joe-skb7/car-rf/doc/motor-driver/module-view.jpg

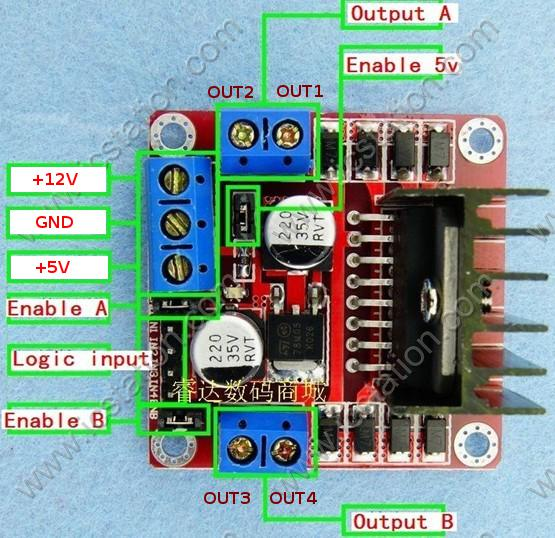
doc/motor-driver/module-view.jpg
