joe-skb7/car-rf/doc/motor-driver/module-scheme.jpg

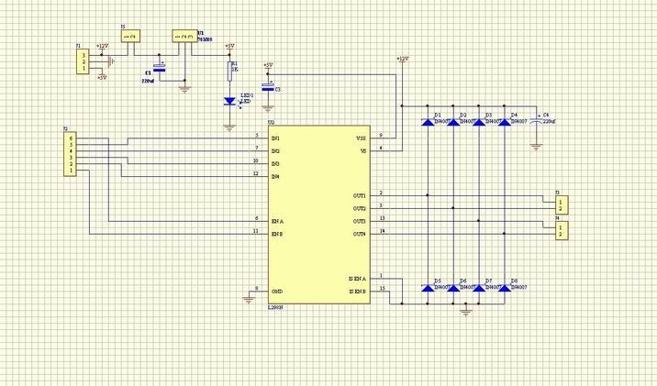
doc/motor-driver/module-scheme.jpg
