joe-skb7/car-rf/doc/ideas.txt

- use protothreads:
  - http://dunkels.com/adam/pt/
  - http://en.wikipedia.org/wiki/Protothreads
- mechanical hand
- 3d-scanner (build map) using laser, camera and beaglebone:
  http://www.makerscanner.com/
  (see MakerBot Digitizer, two-laser scan)
- motor encoders (for monitoring or auto-controlling the speed)
- compass (figure out which rotation angle was accomplished)
- accelerometer/GPS (figure out the speed of car)
