joe-skb7/car-rf/doc/servo/links.txt

http://easyelectronics.ru/servomashinka-hs-311.html
