joe-skb7/car-rf/doc/car/car-scheme.png

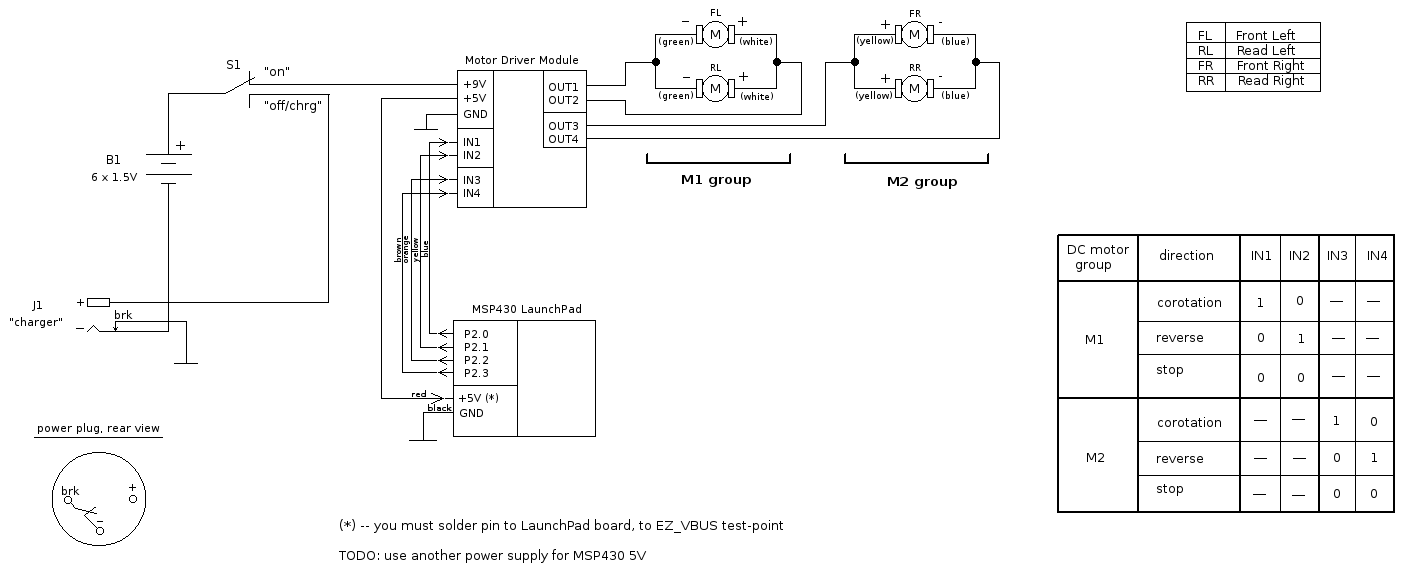
doc/car/car-scheme.png
