joe-skb7/car-rf/doc/joystick/scheme/joystick-connection-scheme.png

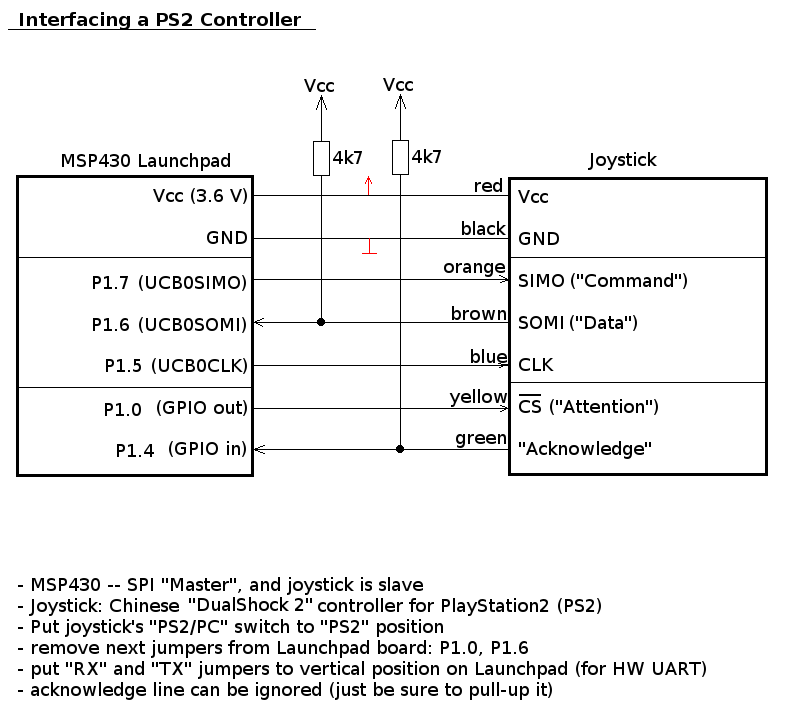
doc/joystick/scheme/joystick-connection-scheme.png
