joe-skb7/car-rf/doc/joystick/spi-config/spi-grace.png

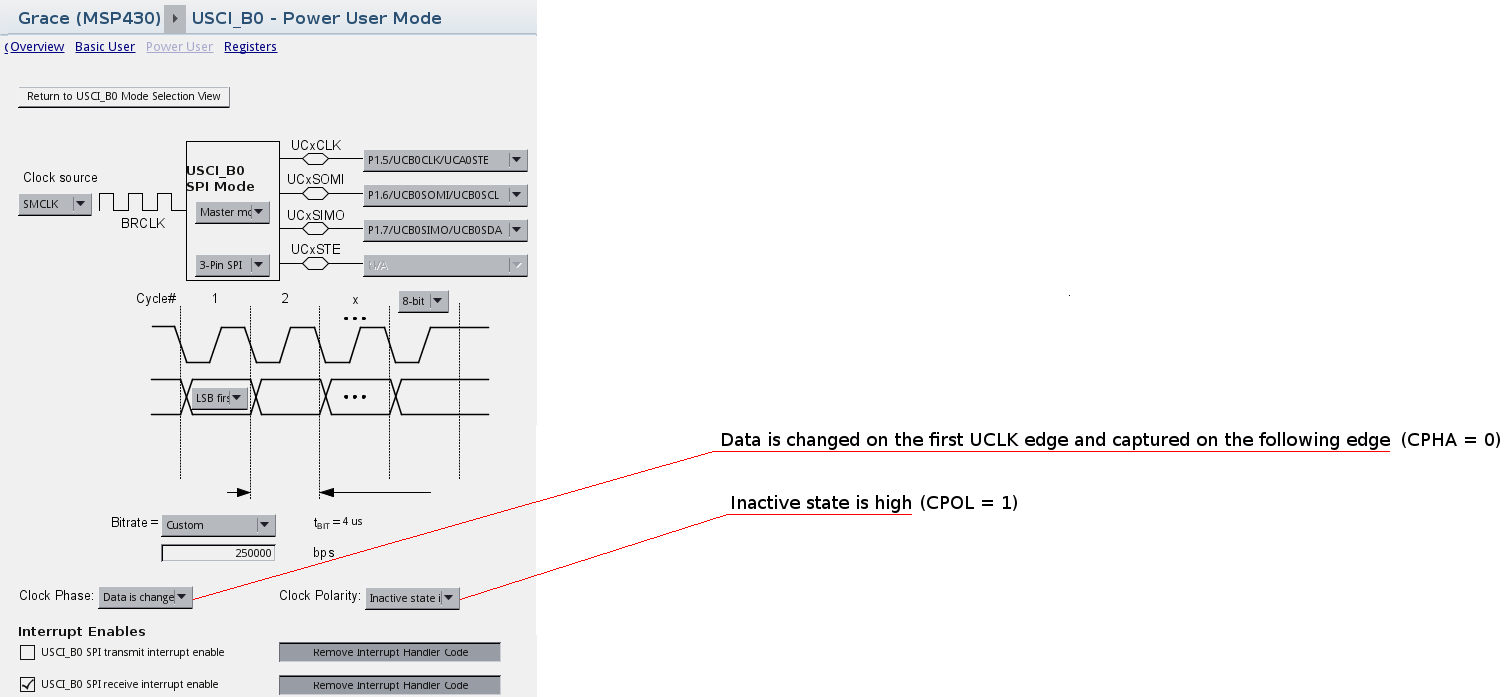
doc/joystick/spi-config/spi-grace.png
