joe-skb7/car-rf/doc/motor/motor-photo.jpg

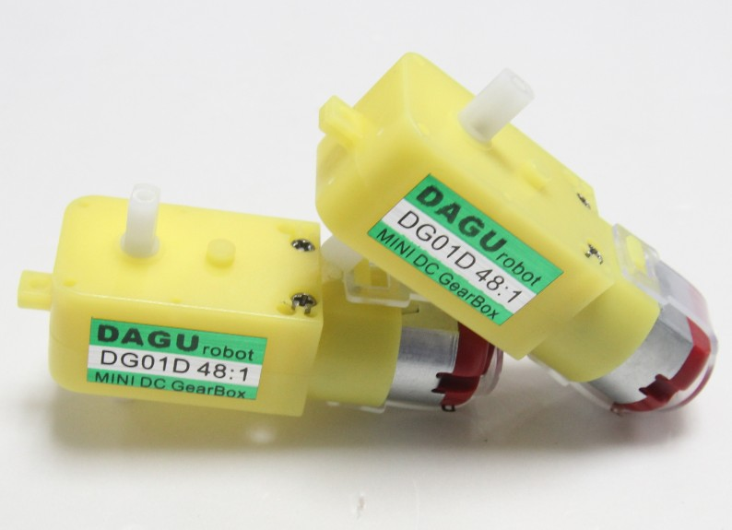
doc/motor/motor-photo.jpg
