joe-skb7/car-rf/doc/uart/uart-pc-scheme.png

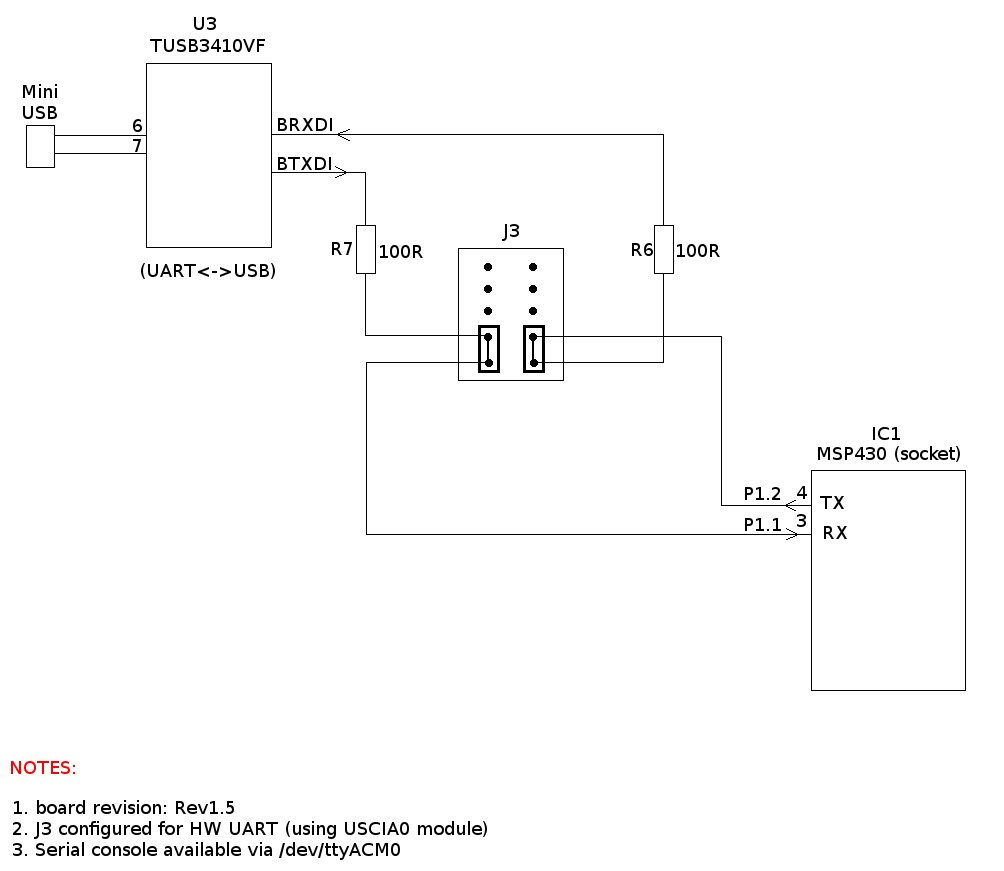
doc/uart/uart-pc-scheme.png
