joe-skb7/car-rf/doc/wireless/spi-config/wl-spi-grace.png

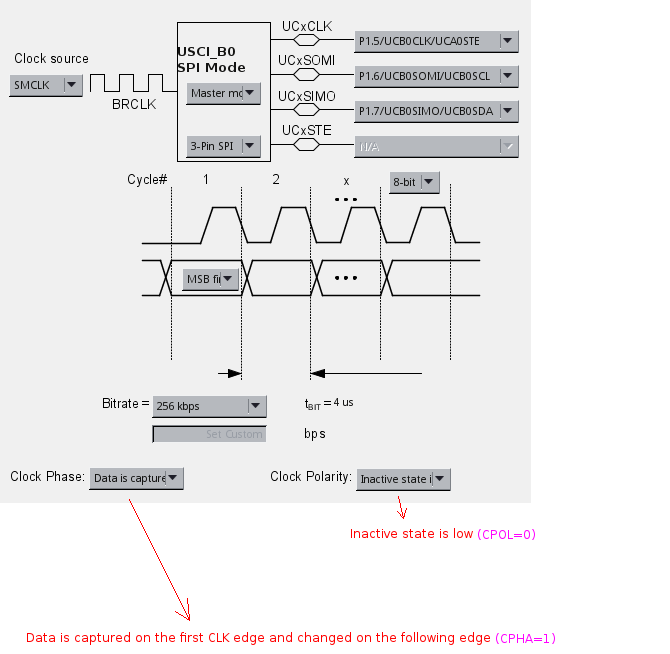
doc/wireless/spi-config/wl-spi-grace.png
