joe-skb7/car-rf/doc/wireless/tk0348-module/NRF24L012_BottomView.jpg

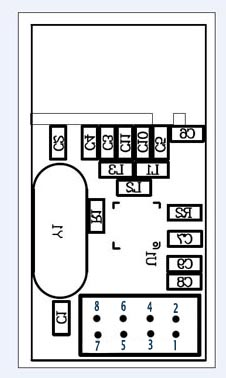
doc/wireless/tk0348-module/NRF24L012_BottomView.jpg
