joe-skb7/car-rf/doc/car/car-wiring.png

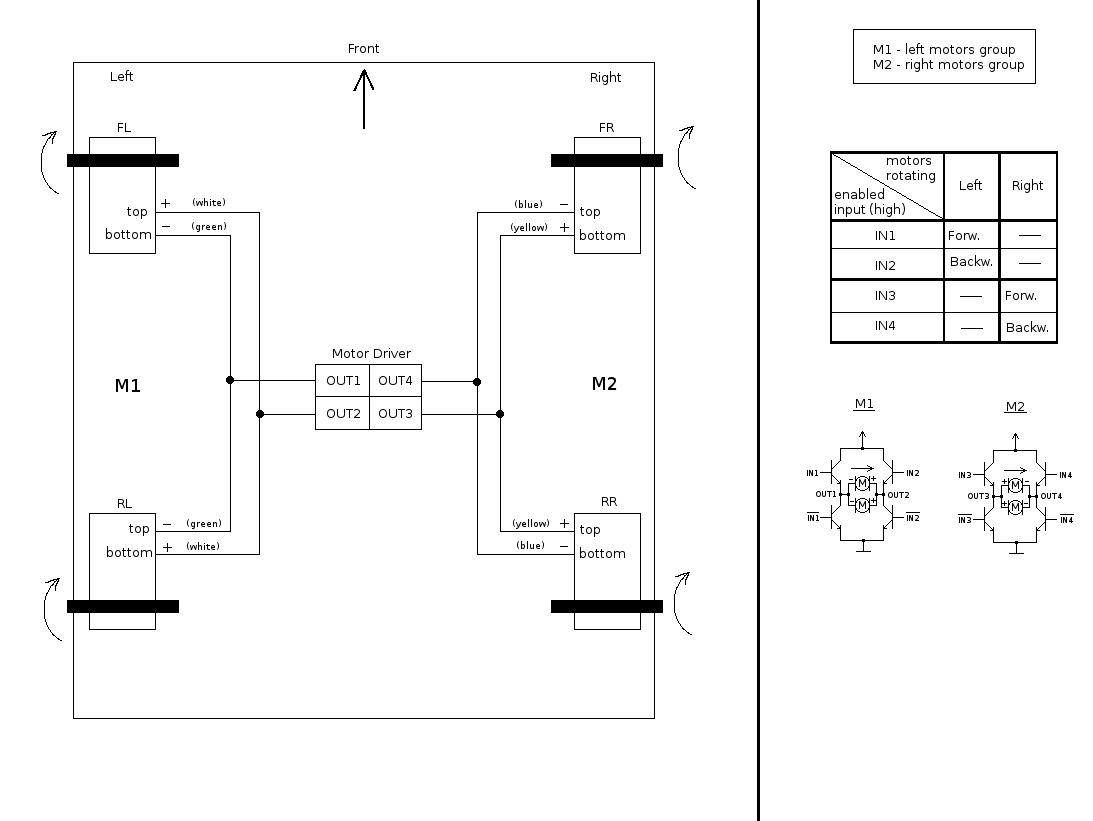
doc/car/car-wiring.png
