joe-skb7/car-rf/doc/pin-usage-scheme.png

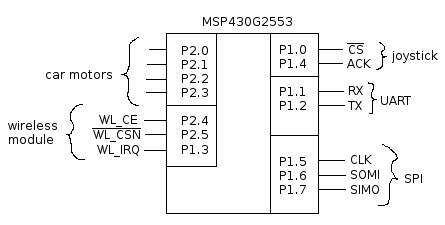
doc/pin-usage-scheme.png
