joe-skb7/car-rf/doc/motor-driver/fix01.txt

Ceramic capacitors 100nF were added to Vs and Vss lines, as recommended by L298 datasheet.
They were soldered to motor driver module board near GND pin.
