joe-skb7/car-rf/doc/motor-suppressor/suppressor-files/pdf/ComponentSilkscreen.pdf

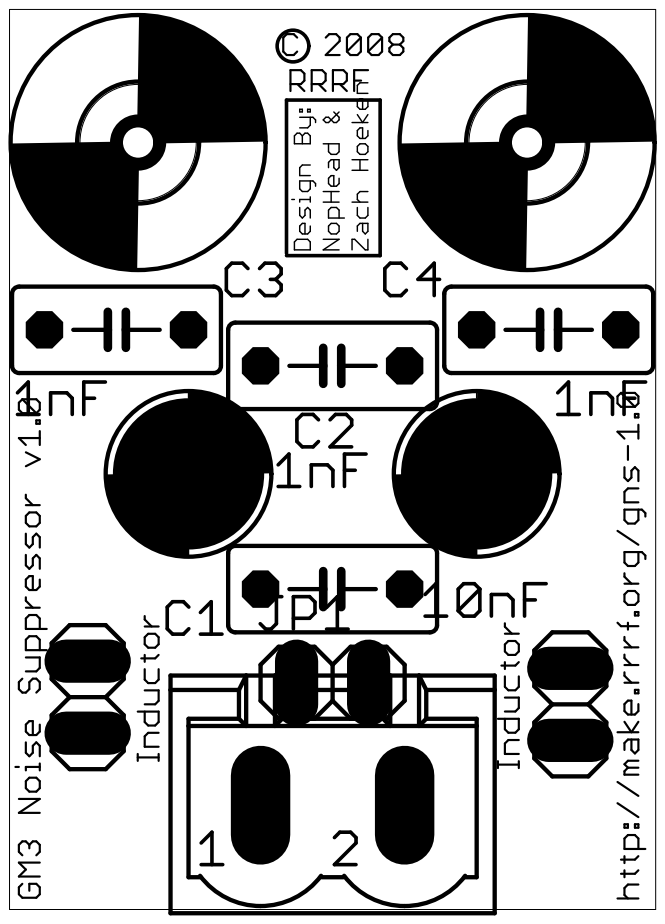
[picture p12: page 1]
