joe-skb7/car-rf/doc/motor-suppressor/suppressor-files/pdf/Schematic.pdf

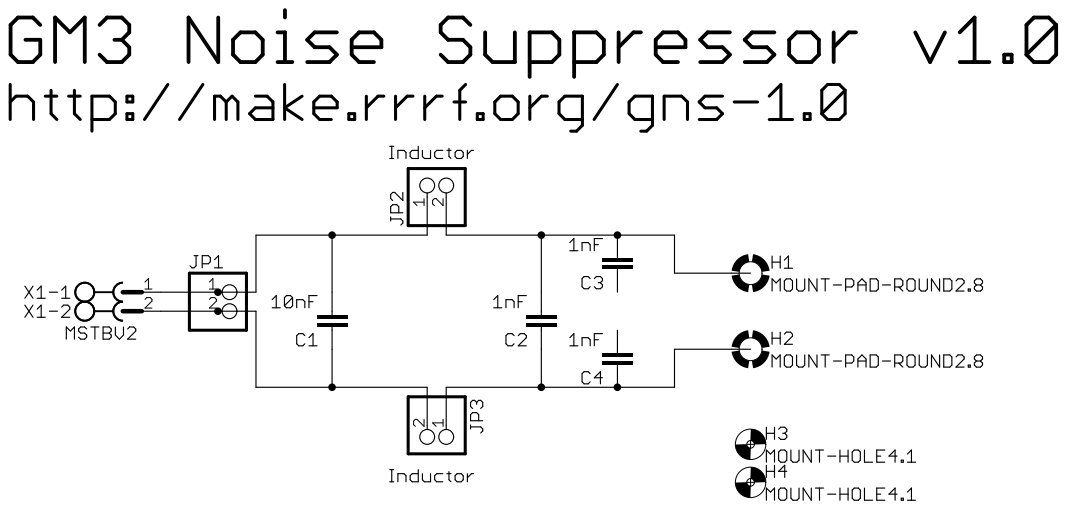
[picture p13: page 1]
