joe-skb7/car-rf/doc/js-wl-boosterpack/eagle/js-wl-msp430.brd

## EAGLE design doc/js-wl-boosterpack/eagle/js-wl-msp430.brd (2013-10-19)

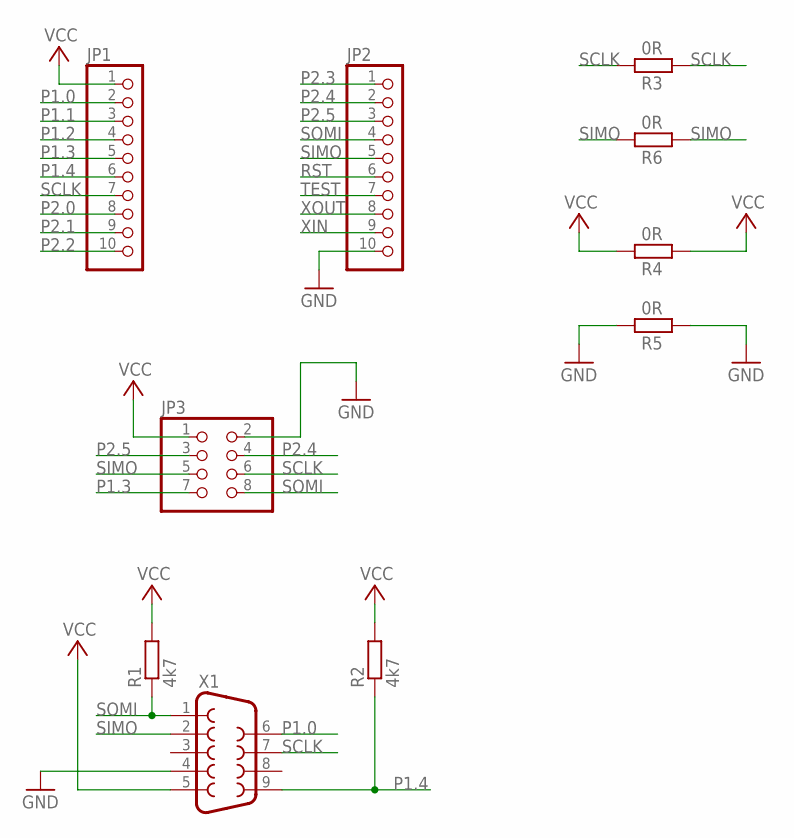
[picture p14: schematic js-wl-msp430.sch]

Parts:
JP1, JP2: PINHD-1X10; 1X10
JP3: PINHD-2X4; 2X04
R1, R2: 4k7; R1206
R3: 0R; R1206
R4, R5, R6: 0R; 0207/12
X1: DB9MALE; DB9_MALE

Connections:
GND: JP2.10, JP3.2, R5.1, R5.2, X1.4
P1.0: JP1.2, X1.6
P1.1: JP1.3
P1.2: JP1.4
P1.3: JP1.5, JP3.7
P1.4: JP1.6, R2.1, X1.9
P2.0: JP1.8
P2.1: JP1.9
P2.2: JP1.10
P2.3: JP2.1
P2.4: JP2.2, JP3.4
P2.5: JP2.3, JP3.3
RST: JP2.6
SCLK: JP1.7, JP3.6, R3.1, R3.2, X1.7
SIMO: JP2.5, JP3.5, R6.1, R6.2, X1.2
SOMI: JP2.4, JP3.8, R1.1, X1.1
TEST: JP2.7
VCC: JP1.1, JP3.1, R1.2, R2.2, R4.1, R4.2, X1.5
XIN: JP2.9
XOUT: JP2.8

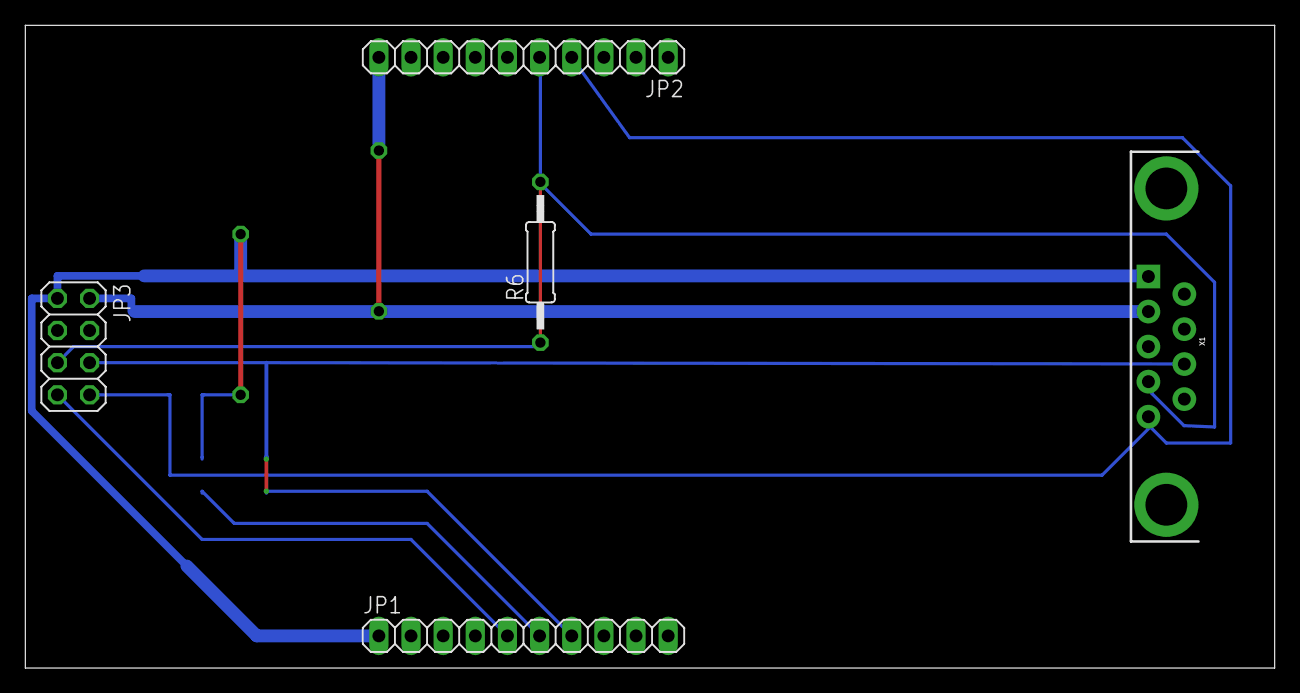
[picture p15: board js-wl-msp430.brd from above]

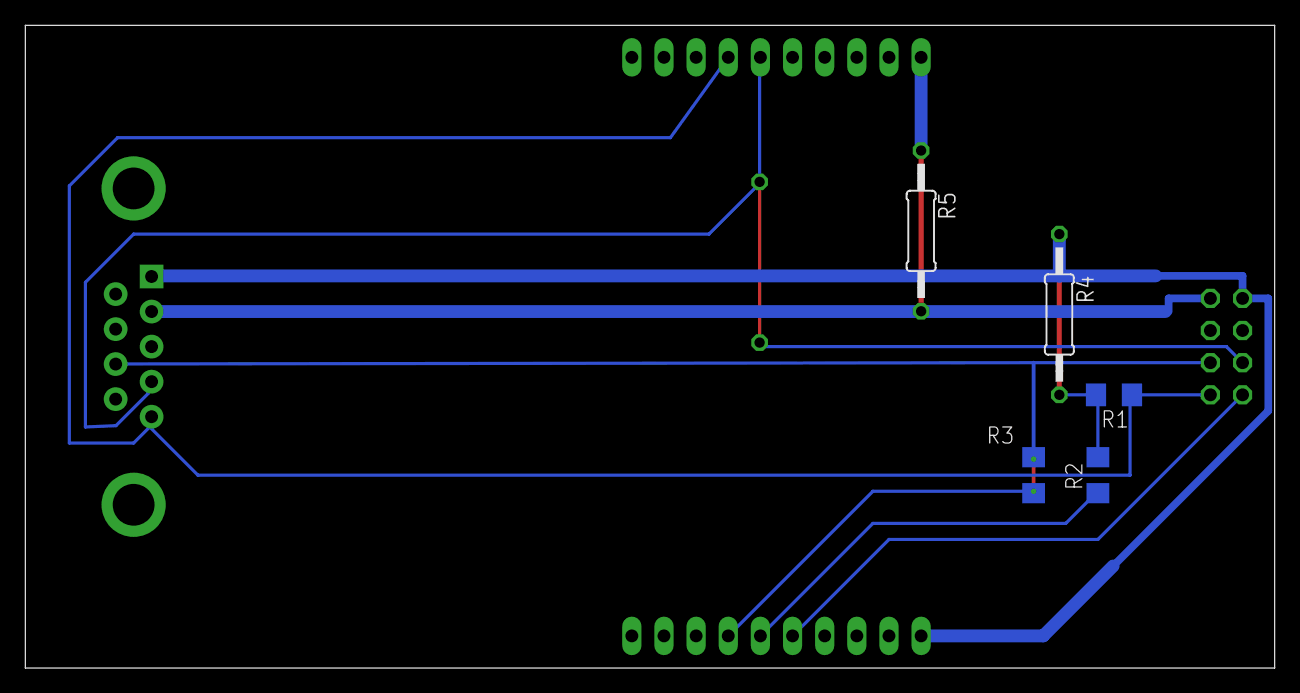
[picture p16: board js-wl-msp430.brd from below]

Board: 2 copper layers, 98.7 x 50.8 mm, 10 parts (5 on the bottom side), 10 nets.
