joe-skb7/car-rf/joystick-wifi/src/ds2/ds2.c

#include <spi/spi.h>
#include <ds2/ds2.h>
#include <msp430.h>

void ds2_init_spi(void)
{
	spi_init(0, 1, 0);
}

void ds2_init(void)
{
	/* P1.0 - OUT (Joystick's Chip Select, "Attention")
	 * P1.4 - IN  ("Acknowledge")
	 */
	P1DIR |= BIT0;
	P1OUT |= BIT0; /* up on idle */

	ds2_init_spi();
}

void ds2_poll_buttons_sync(unsigned int *buttons)
{
	unsigned char request[] = {0x01, 0x42, 0x00, 0x00, 0x00, 0x00, 0x00,
		0x00, 0x00};
	unsigned char response[9];

	ds2_send_receive_packet_sync(request, response, 9);

	if (buttons) {
		((uint8_t*)buttons)[0] = response[3];
		((uint8_t*)buttons)[1] = response[4];
	}
}

void ds2_send_receive_packet_sync(const unsigned char* send_packet,
		unsigned char* receive_packet, size_t size)
{
	/* Enable Joystick Chip Select: set "Attention" line to 0 */
	P1OUT &= ~BIT0;

	spi_send_receive_packet_sync(send_packet, receive_packet, size);

	/* Release CS */
	P1OUT |= BIT0;
}

/* TODO: do smth w/ handshake routine */
#if 0
int ds2_handshake(void)
{
	uint8_t send_data[] = {0x01, 0x01, 0x01, 0x01, 0x01, 0x01};
	uint8_t receive_data[6];
	size_t i;

	spi_send_receive_packet_sync(send_data, receive_data, 6);

	for (i = 0; i < 6; ++i) {
		if (0xff != receive_data[i])
			return 1;
	}

	return 0;
}
#endif
