joe-skb7/car-rf/(commit log)

2013-08-31 initial commit
    By now we have joystick and UART (PC serial console) working.
    [BOM.ods, joe-breakout.brd, joystick-protocol-at-startup.ods, spi-params.txt]
2013-08-31 Moved ds2 and spi code to their corresponding .h and .c files
2013-08-31 Moved some functions from ds2 to spi
2013-08-31 Moved interrupt stuff to interrupts.c
2013-08-31 cc2500: improve cc2500 breakout PCB
    Arrange two same PCBs horizontally (instead of vertical layout)
    so that it can be printed with economy of PCB tape.
    [joe-breakout.brd]
2013-08-31 ds2: fix sparse warning
    Thi patch fixes next sparse warning:
    "./src/ds2/ds2.c:3:6: warning: symbol 'ds2_poll_buttons_sync' was not declared.
    Should it be static?"
    [ds2.c]
2013-08-31 makefile: check static analyzer parameters
    With "-quiet" parameter splint gave such a warning:
    "Command Line: Setting -quiet redundant with current value"
    So remove "-quiet" for now.
2013-08-31 interrupts: fix static analyzer warnings
    Fix next warnings gotten from splint:
    src/interrupts.c: (in function usci0rx_isr)
    src/interrupts.c:35:17: Function usci0a_rx_cb expects arg 1 to be uint8_t gets
    char: (char)UCA0RXBUF
    src/interrupts.c:41:17: Function usci0b_rx_cb expects arg 1 to be uint8_t gets
    char: (char)UCB0RXBUF
2013-08-31 joystick: remove duplicate uart scheme
2013-08-31 joystick: move joystick files 1 level top
    After removing duplicate scheme, there is 1 redundant dir level.
    Fix it.
    [ds2.c, main.c, spi.c]
2013-08-31 doc: move doc files to dedicated directory
    [BOM.ods]
2013-09-01 rearrange project stucture
    Project structure was a way redundant. Fix it.
    [joe-breakout.brd, joystick-protocol-at-startup.ods, spi-params.txt]
2013-09-01 doc: sync BOM to be up-to-date
    [BOM.ods]
2013-09-01 doc: convert BOM to CSV
    CSV is text format and should be better for git that ODS.
    [BOM.ods, bom.csv]
2013-09-01 interrupts: unify coding style
2013-09-01 spi: coding issues
2013-09-01 uart: fix comment
2013-09-01 spi: mark debug code for remove
2013-09-01 spi: coding style: general headers on top
2013-09-01 spi: mark debug header to remove
2013-09-01 uart: coding style: fix erroneous comment
    [uart.c]
2013-09-03 car: doc: add chassis documentation
2013-09-03 car: doc: add motors specs
2013-09-03 car: doc: add motor driver (HW) documentation
2013-09-03 doc: update actual motor driver at BOM
    [bom.csv]
2013-09-03 doc: update BOM to be up-to-date
    [bom.csv]
2013-09-03 car: doc: add URL for motor booster-pack
    Information about motor booster-pack for MSP430 may be useful
    in future, so just leave link for it in docs.
2013-09-07 doc: update BOM
    Batteries and charger are bought.
    [bom.csv]
2013-09-08 car: add test code for car chassis
    This code allows car only to move back and forth.
    It's just for test to be sure that motors and driver works and scheme
    assembled correct.
    [main.c]
2013-09-08 doc: add wishes to BOM
    [bom.csv]
2013-09-08 car: make motor action synchronous
2013-09-08 doc: update BOM
    Update BOM, adding all the items were bought at Kardachi.
    [bom.csv]
2013-09-09 car: split vehicle code into 2 separate module
    Now we have 2 modules:
    - motor-driver: implements low-level control of motor driver
    - vehicle: implements high-level commands ("forward", "stop" etc)
2013-09-28 wireless: relocate ti wl module documentation
    [joe-breakout.brd]
2013-09-28 wireless: add nRF24L01 documentation
    nRF24L01 chip and TK0348 module specifications.
2013-09-28 car: pull down port 3 lines as recommended in datasheet
    From datasheet:
    "NOTE: The pulldown resistors of port P3 should be
    enabled by setting P3REN.x = 1."
2013-09-28 joystick: pull down port 3 lines as recommended in datasheet
    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
2013-09-28 wireless: add spi configuration from Grace
2013-09-28 wireless: add useful links to doc
2013-10-19 joystick: add joystick wifi boosterpack
    Add Eagle files (PCB+Schematic) for "Wireless Joystick Boosterpack".
    It's a board with sockets for:
    - MSP430 Launchpad
    - Joystick (joystick socket needs to be replaced by DB9-F socket)
    - Wireless module (NRF24L01)
    This board just connects MSP430 Launchpad with joystick and Wireless
    module.
    [js-wl-msp430.brd, js-wl-msp430.sch]
2013-10-19 doc: move common documentation from joystic doc
    [joe-breakout.brd]
2013-10-19 doc: remove unused docs
    We are decided to use NRF24L01 instead of CC2500. So CC2500 docs
    can be removed now.
    [joe-breakout.brd]
2013-10-19 doc: move all docs to common
    It would be more convenient to keep all docs at one place.
    So move docs from "car" project and "joystick" project to one place
    (top dir doc).
    [joystick-protocol-at-startup.ods, js-wl-msp430.brd, js-wl-msp430.sch, spi-params.txt]
2013-10-19 doc: yet another rearrangement
    Make docs more accesible.
    [js-wl-msp430.brd, js-wl-msp430.sch]
2013-10-19 doc: move eagle files back to "eagle" dir
    New files will be added soon, so prepare for this.
    [js-wl-msp430.brd, js-wl-msp430.sch]
2013-10-19 doc: add joystick socket soldering instructions
2013-10-20 doc: add TODO for joystick boosterpack
    PCB was made in wrong way. It works now only with
    JP1/JP2 extenders. Rework it later.
2013-10-20 Joystick: wireless implementation
2013-10-20 doc: add general msp430 pin usage scheme
2013-10-20 libspi: remove it
    See common/{src/include}/spi for SPI driver code.
2013-10-20 doc: fix motor driver module view
    Fix and enhance motor driver view:
    - Fix 12V/5V marks
    - Add OUT1..OUT4 marks
2013-10-21 car: fix incorrect motor driver code
    [motor_driver.c]
2013-10-21 car: make car being controlled by wireless joystick
2013-11-10 car: fix interrupt variable
    Use "volatile" keyword for global variables involved to interrupt
    routine.
    [main.c]
2013-11-10 Do not send button states if nothing changed
2013-11-10 Unset msp interrupt flag before unsetting wl module interrupt flag
2013-11-10 wl: fix global interrupt variable
    Use "volatile" keyword for global variables used in interrupt.
    [wl.c]
2013-11-10 doc: motor-suppressor: add files
    Since DC motors noise issue was revealed, there is need to
    develop noise suppressors. Info found in net was added.
2013-11-10 doc: motor-driver: fix 01
    Add ceramic capacitors (100n) to Vs and Vss line, as recommended
    by datasheet.
2013-11-11 doc: motor-suppressor: add detailed explanation of issue
2013-11-16 doc: motor-suppressor: add a bit more details
2013-11-16 doc: motor-suppressor: rearrange doc files
    [gm3-noise-suppressor.brd, gm3-noise-suppressor.sch]
2013-11-16 doc: motor-suppressor: add grounding recommendations
2014-01-07 car: fix debug code
    [main.c]
2014-01-07 uart: fix clang static analyzer warning
    Fix this warning:
    scan-build: Using '/usr/bin/clang' for static analysis
    ../common/src/uart/uart.c:62:2: warning: Undefined or garbage value
    returned to caller
    return ret;
    [uart.c]
2014-01-07 doc: add servo docs
2014-01-07 doc: add inductor info to motor-suppressor docs
